IEA4/Autonomous-GSM-sensor/Печатная плата/Внешний вид платы.jpg

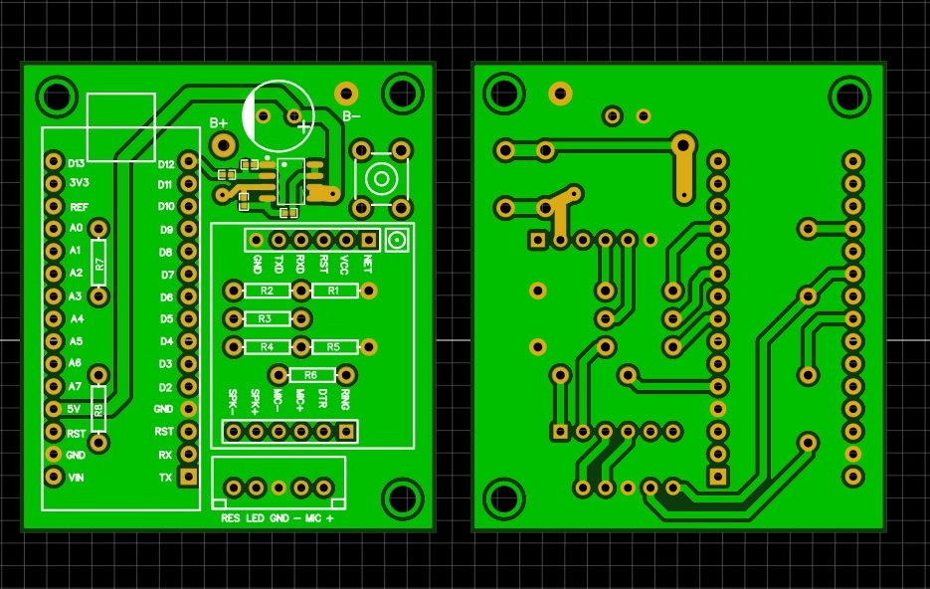
Печатная плата/Внешний вид платы.jpg
