IEA4/Autonomous-GSM-sensor/Печатная плата/3D-вид платы/3.jpg

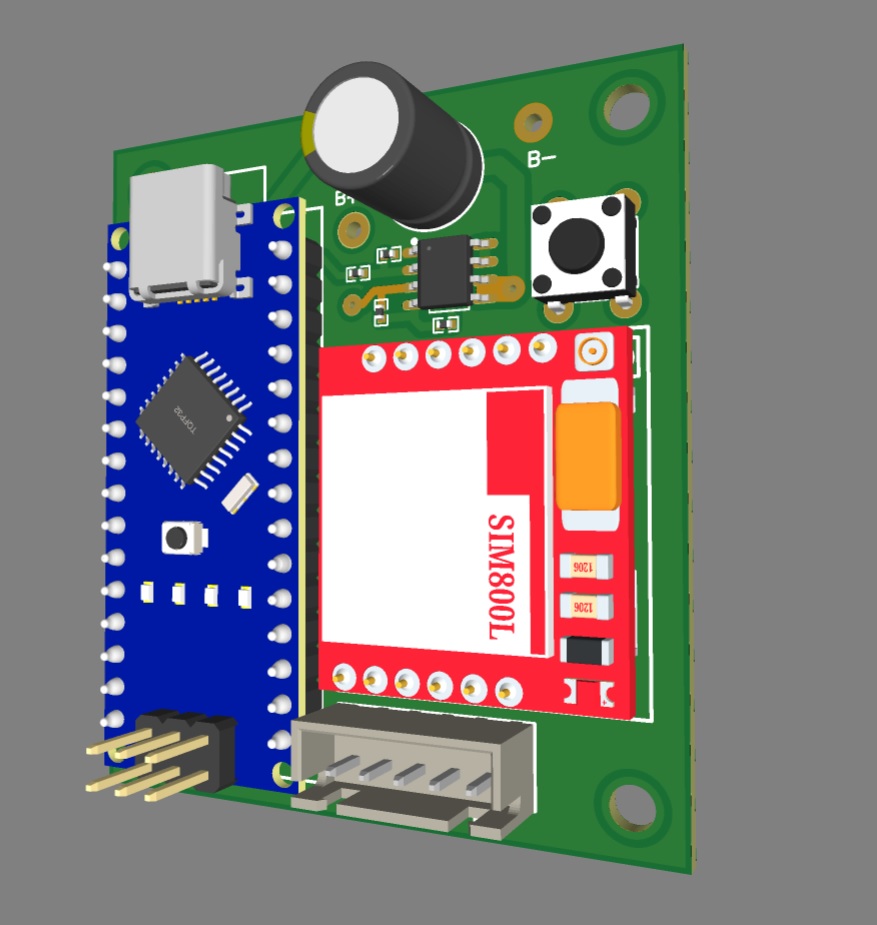
Печатная плата/3D-вид платы/3.jpg
