IEA4/Autonomous-GSM-sensor/Autonom_GSM-detector/CМС с одной роеловки.jpg

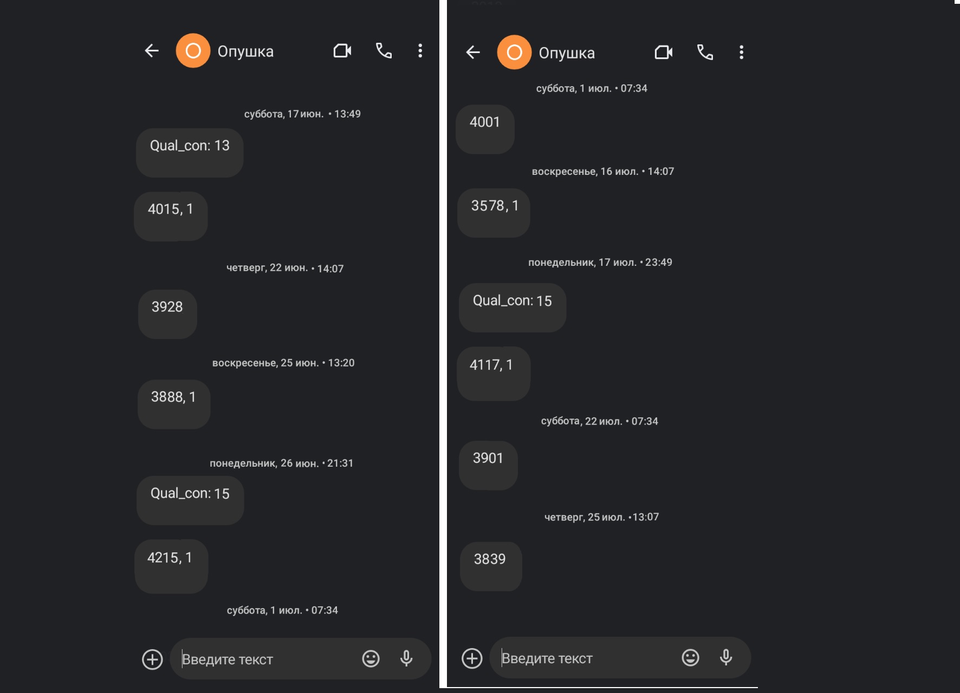
Autonom_GSM-detector/CМС с одной роеловки.jpg
