IEA4/Autonomous-GSM-sensor/Autonom_GSM-detector/Оптмальная схема.jpeg

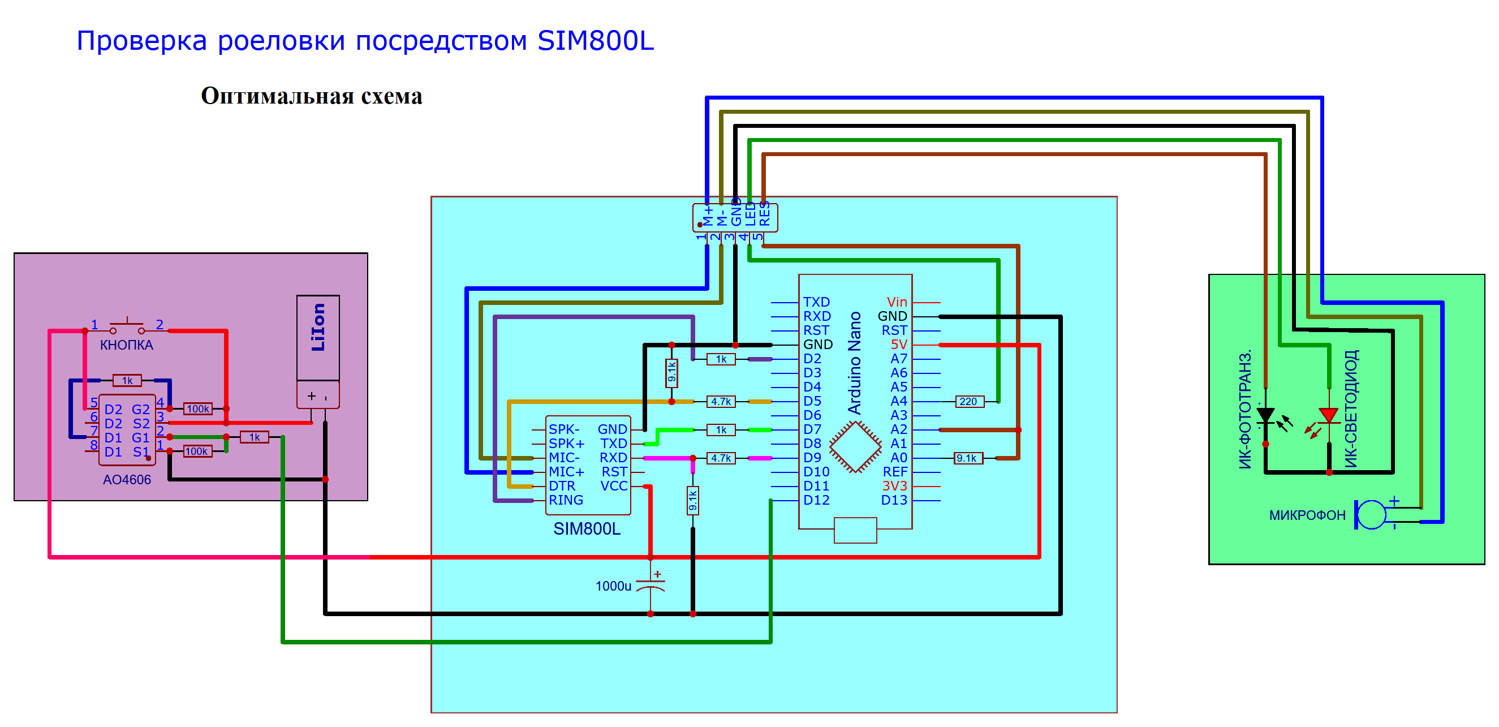
Autonom_GSM-detector/Оптмальная схема.jpeg
