IEA4/Autonomous-GSM-sensor/Autonom_GSM-detector/Универсальная схема.jpeg

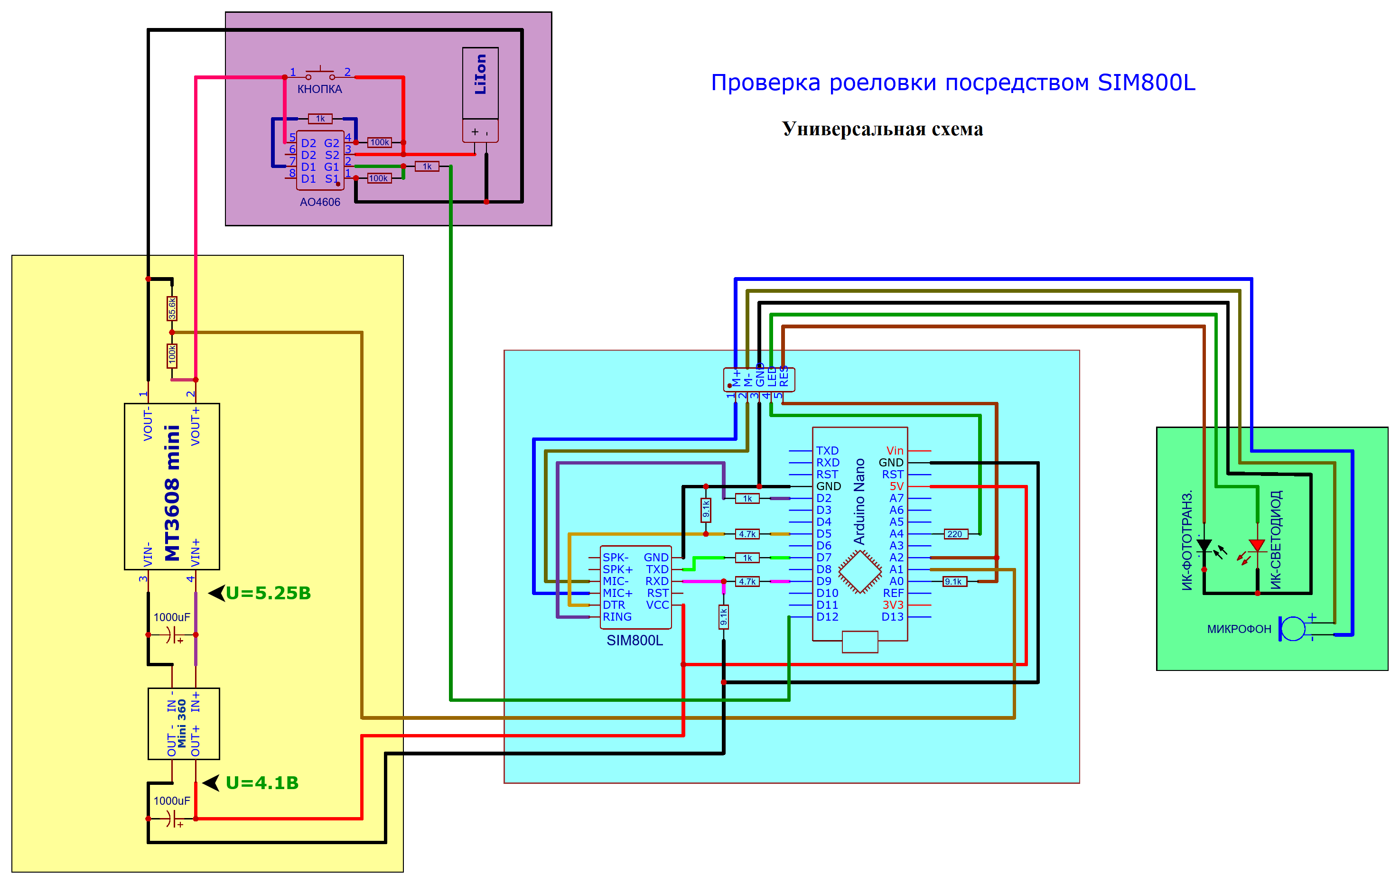
Autonom_GSM-detector/Универсальная схема.jpeg
