IEA4/Autonomous-GSM-sensor/Печатная плата/3D-вид платы/2.jpg

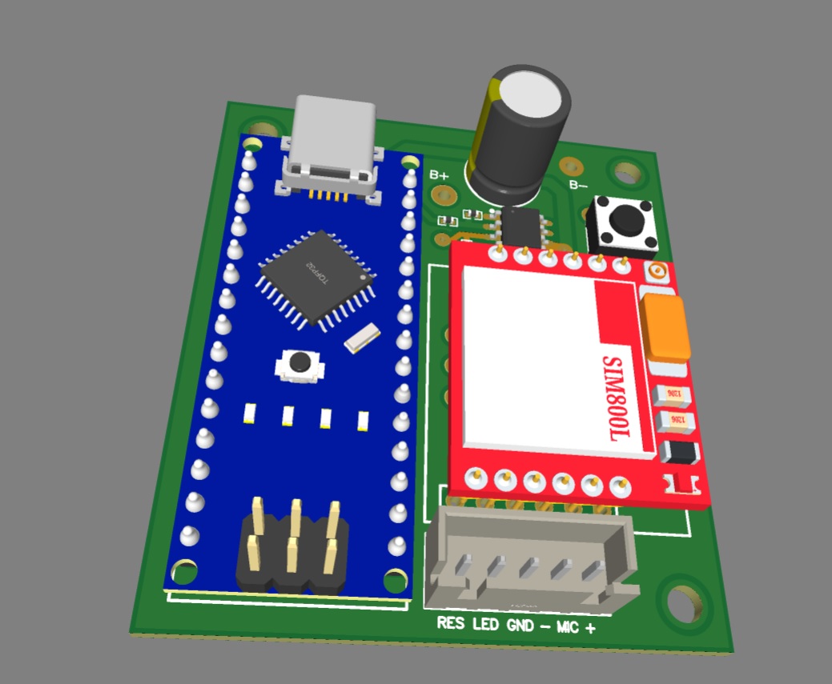
Печатная плата/3D-вид платы/2.jpg
