IEA4/Autonomous-GSM-sensor/Test_AT_command/Схема для Test_AT_command.jpg

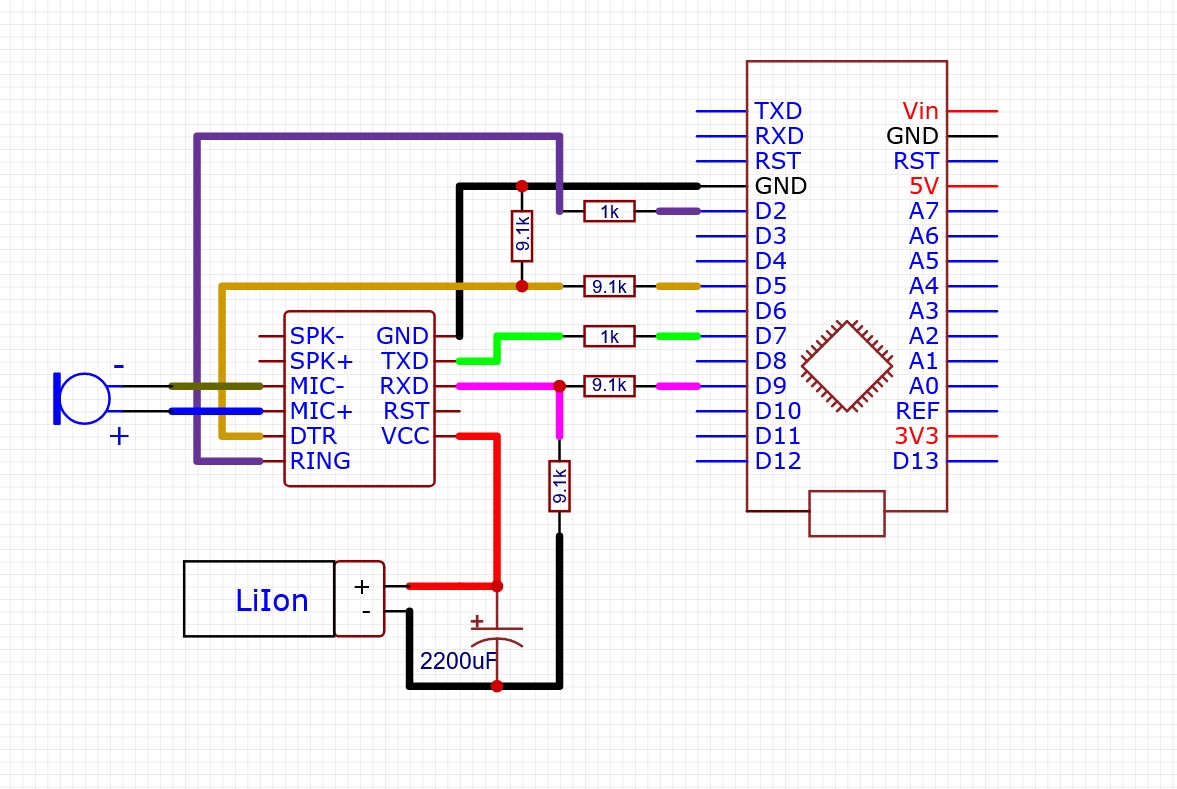
Test_AT_command/Схема для Test_AT_command.jpg
