IEA4/Autonomous-GSM-sensor/Test_IR_detector/Схема для Test_IR_detector.jpg

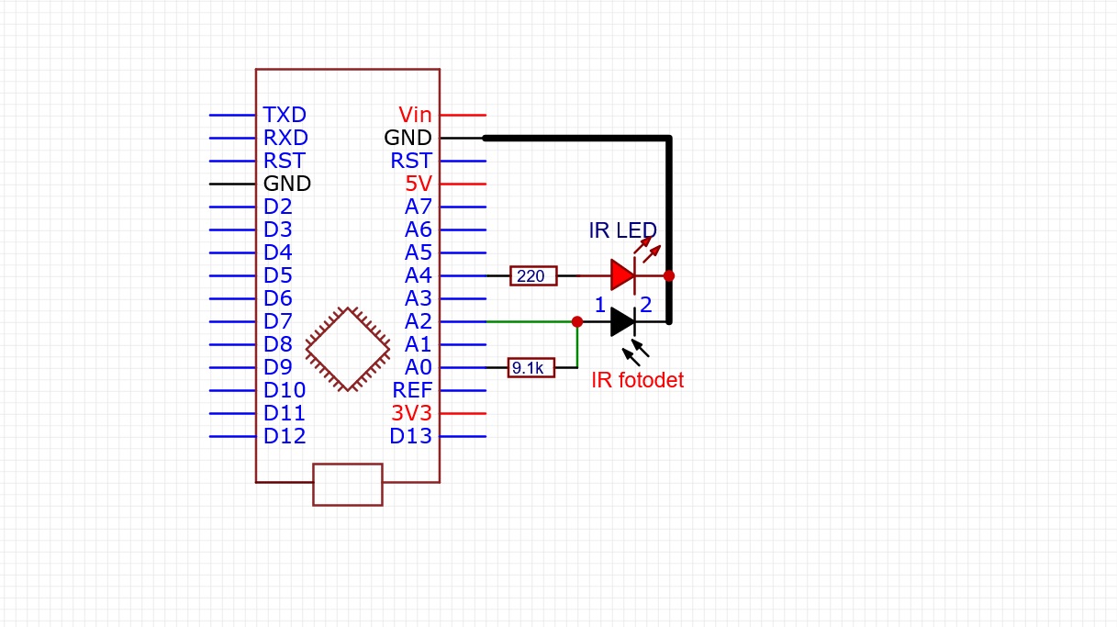
Test_IR_detector/Схема для Test_IR_detector.jpg
