IEA4/Autonomous-GSM-sensor/(commit log)

2023-10-05 fixed quility_con() & chardge_parsing() functions
    [Autonom_GSM-detector.ino]
2023-11-08 Oптимизировал и исправил ошибки
    [Autonom_GSM-detector.ino]
